starcat-io/jupiter-nano/jupiter-nano/stack-up.md

# Stack Up

- F.Cu   : route
- In1.Cu : GND
- In2.Cu : VDDCORE (1V2)
- In3.Cu : VDD_3V3 (3V3)
- In4.Cu : VDDIODDR (1V8)
- B.Cu   : route
