starcat-io/jupiter-nano/jupiter-nano/dimensions.txt

width 1.535 in  29.21  mm
height 2.48 in  69.992 mm
