starcat-io/jupiter-nano/jupiter-nano/3dmodels/ZX62-AB-5PA-gray.step

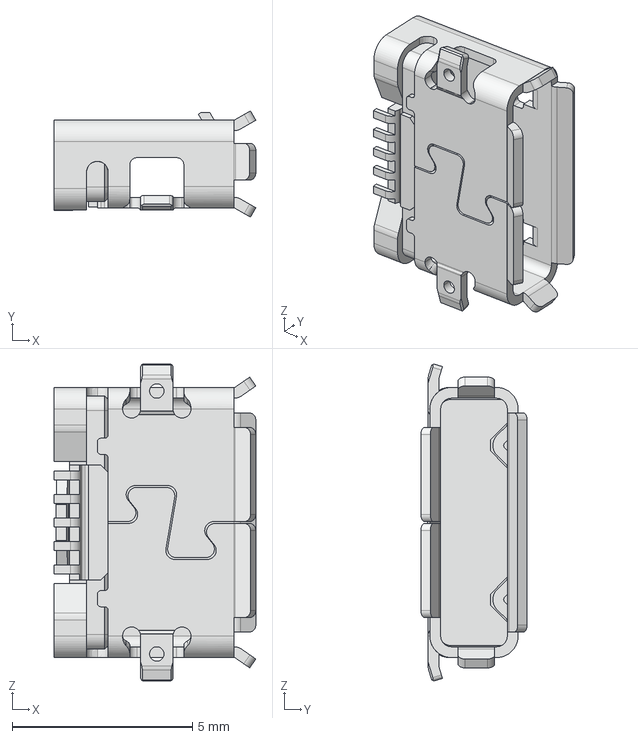
[picture p4: CAD file, 2021-07-31]
jupiter-nano/3dmodels/ZX62-AB-5PA-gray.step
5.60 x 2.95 x 8.80 mm
