starcat-io/jupiter-nano/jupiter-nano/3dmodels/PTS810_SJM_250_SMTR_LFS.step

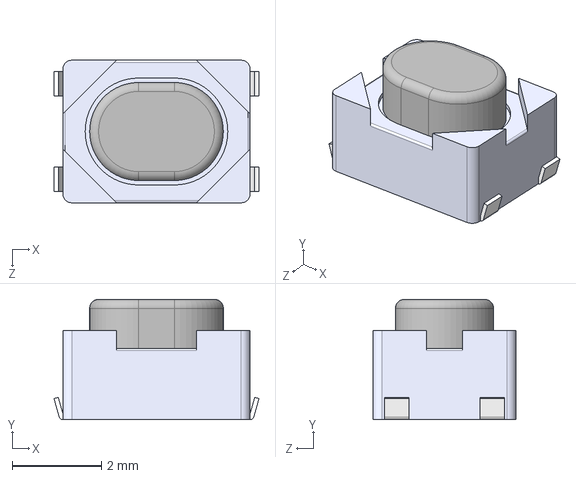
[picture p5: CAD file, 2021-07-31]
jupiter-nano/3dmodels/PTS810_SJM_250_SMTR_LFS.step
4.60 x 2.70 x 3.20 mm
