starcat-io/jupiter-nano/jupiter-nano/3dmodels/IND_TAIYO_NR3015_TAY.step

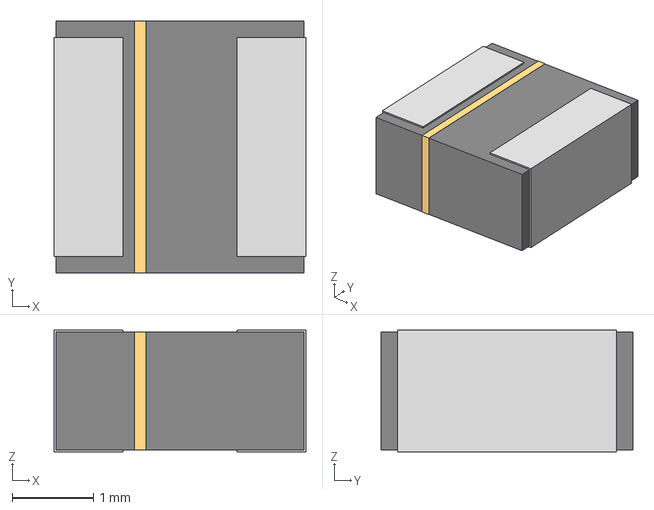
[picture p6: CAD file, 2020-11-12]
jupiter-nano/3dmodels/IND_TAIYO_NR3015_TAY.step
3.10 x 3.10 x 1.50 mm
