starcat-io/jupiter-nano/jupiter-nano/3dmodels/ZX62D-AB-5P8.step

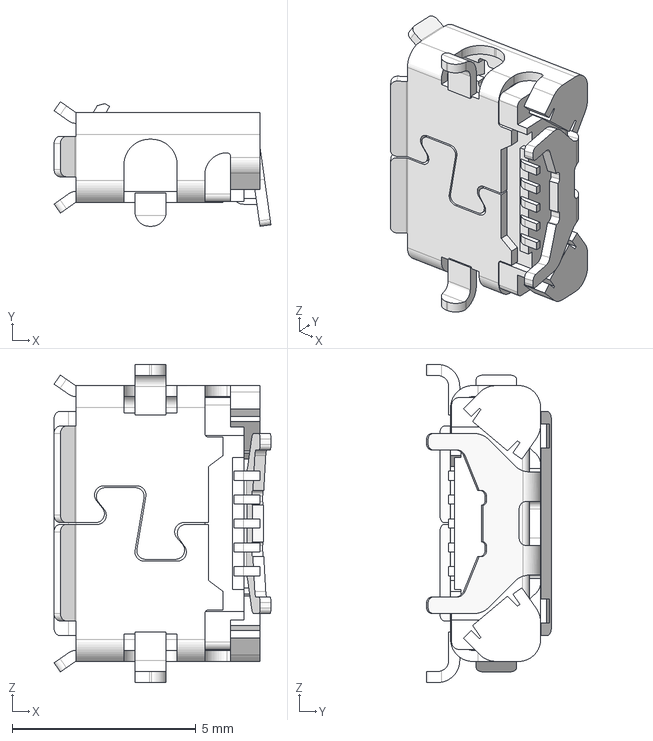
[picture p7: CAD file, 2020-11-12]
jupiter-nano/3dmodels/ZX62D-AB-5P8.step
5.90 x 3.39 x 8.65 mm
