starcat-io/jupiter-nano/jupiter-nano/3dmodels/QFN20_5x5MC_MCH.step

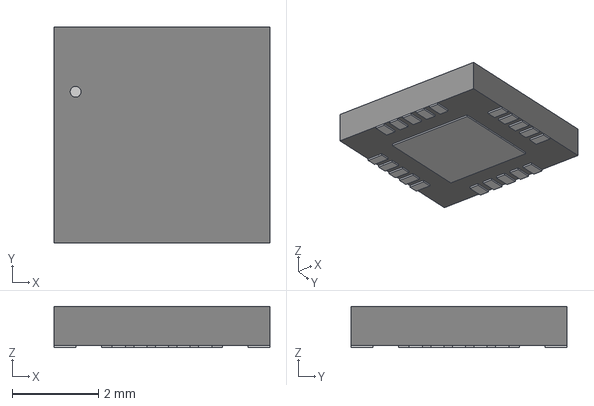
[picture p8: CAD file, 2020-11-12]
jupiter-nano/3dmodels/QFN20_5x5MC_MCH.step
5.00 x 5.00 x 0.952 mm
