starcat-io/jupiter-nano/jupiter-nano/3dmodels/UDFN8_2x3MC_MCH.step

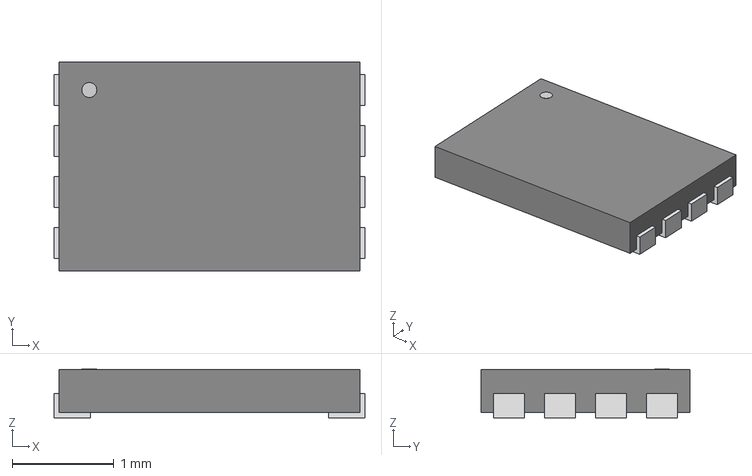
[picture p9: CAD file, 2020-11-12]
jupiter-nano/3dmodels/UDFN8_2x3MC_MCH.step
3.05 x 2.05 x 0.476 mm
