starcat-io/jupiter-nano/jupiter-nano/3dmodels/amphenol-sdcard-socket-1140084168.STEP

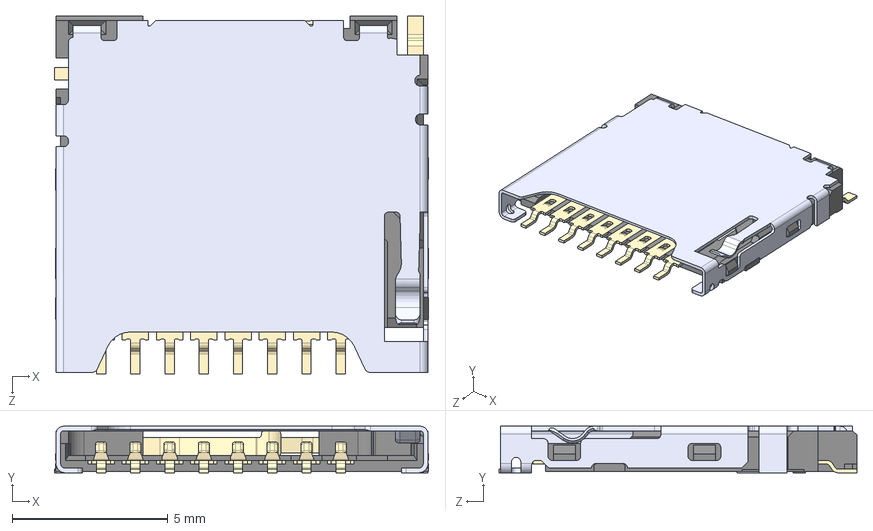
[picture p10: CAD file, 2020-11-12]
jupiter-nano/3dmodels/amphenol-sdcard-socket-1140084168.STEP
12.0 x 1.50 x 11.5 mm
