starcat-io/jupiter-nano/jupiter-nano/3dmodels/4WLCSP.step

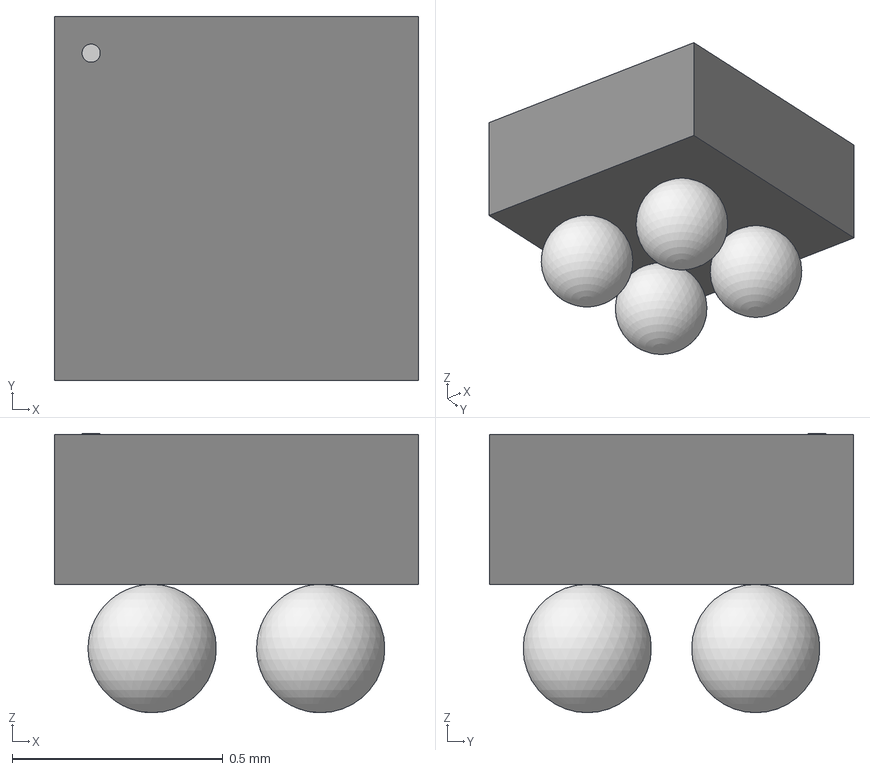
[picture p11: CAD file, 2020-11-12]
jupiter-nano/3dmodels/4WLCSP.step
0.864 x 0.864 x 0.663 mm
