starcat-io/jupiter-nano/jupiter-nano/3dmodels/TFBGA361_16X16_MCH.step

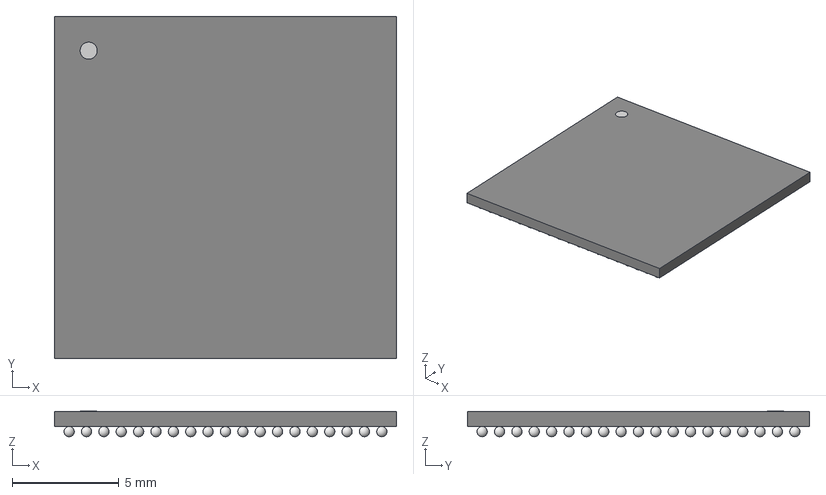
[picture p12: CAD file, 2020-11-12]
jupiter-nano/3dmodels/TFBGA361_16X16_MCH.step
16.0 x 16.0 x 1.20 mm
