starcat-io/jupiter-nano/jupiter-nano/3dmodels/SOT-23-5_M5_MCH.step

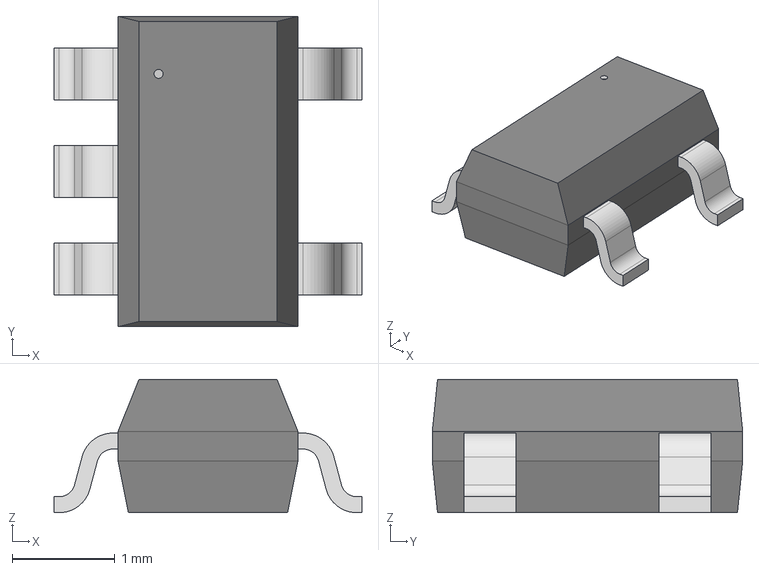
[picture p13: CAD file, 2020-11-12]
jupiter-nano/3dmodels/SOT-23-5_M5_MCH.step
3.00 x 3.02 x 1.30 mm
