starcat-io/jupiter-nano/jupiter-nano/3dmodels/TQFN55-40.STEP

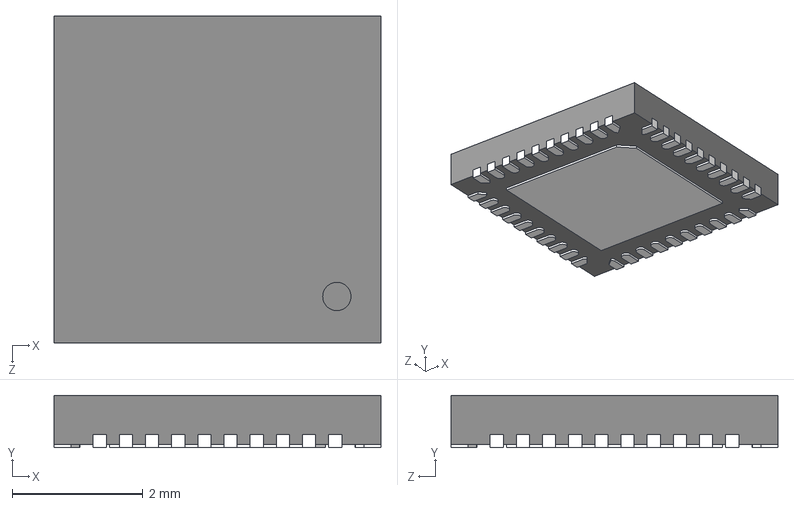
[picture p14: CAD file, 2020-11-12]
jupiter-nano/3dmodels/TQFN55-40.STEP
5.00 x 0.8 x 5.00 mm
