starcat-io/jupiter-nano/jupiter-nano/3dmodels/PTS810.step

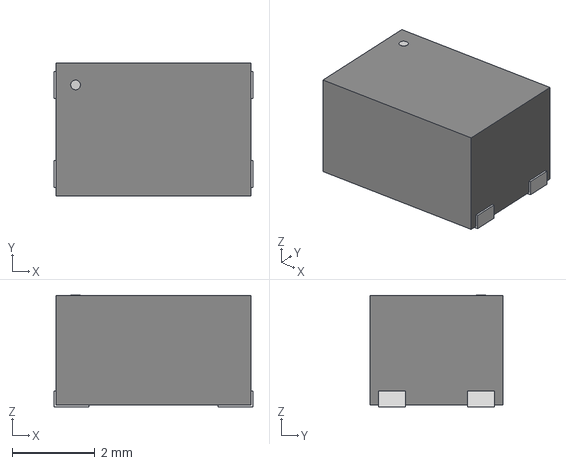
[picture p15: CAD file, 2020-11-12]
jupiter-nano/3dmodels/PTS810.step
4.80 x 3.20 x 2.69 mm
