starcat-io/jupiter-nano/jupiter-nano/3dmodels/NX3225SA.STEP

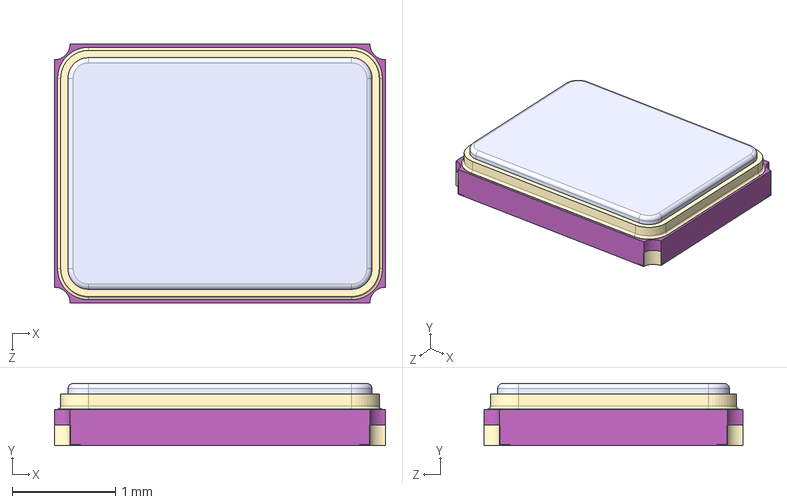
[picture p16: CAD file, 2020-11-12]
jupiter-nano/3dmodels/NX3225SA.STEP
3.20 x 0.6 x 2.50 mm
