starcat-io/jupiter-nano/(list of files, cad)

Other CAD files:
jupiter-nano/3dmodels/QFN20_5x5MC_MCH-M.step
jupiter-nano/3dmodels/ZX62-AB-5PA.stp
jupiter-nano/3dmodels/TFBGA361_16X16_MCH-L.step
jupiter-nano/3dmodels/TFBGA361_16X16_MCH-M.step
jupiter-nano/3dmodels/SOT-23-5_M5_MCH-M.step
jupiter-nano/3dmodels/UDFN8_2x3MC_MCH-L.step
jupiter-nano/3dmodels/UDFN8_2x3MC_MCH-M.step
jupiter-nano/3dmodels/QFN20_5x5MC_MCH-L.step
jupiter-nano/3dmodels/SOT-23-5_M5_MCH-L.step
jupiter-nano/3dmodels/M50-3600542.STEP
jupiter-nano/3dmodels/TQFN55-40.FCStd
