starcat-io/jupiter-nano/jupiter-nano/jupiter-nano-schematic.pdf

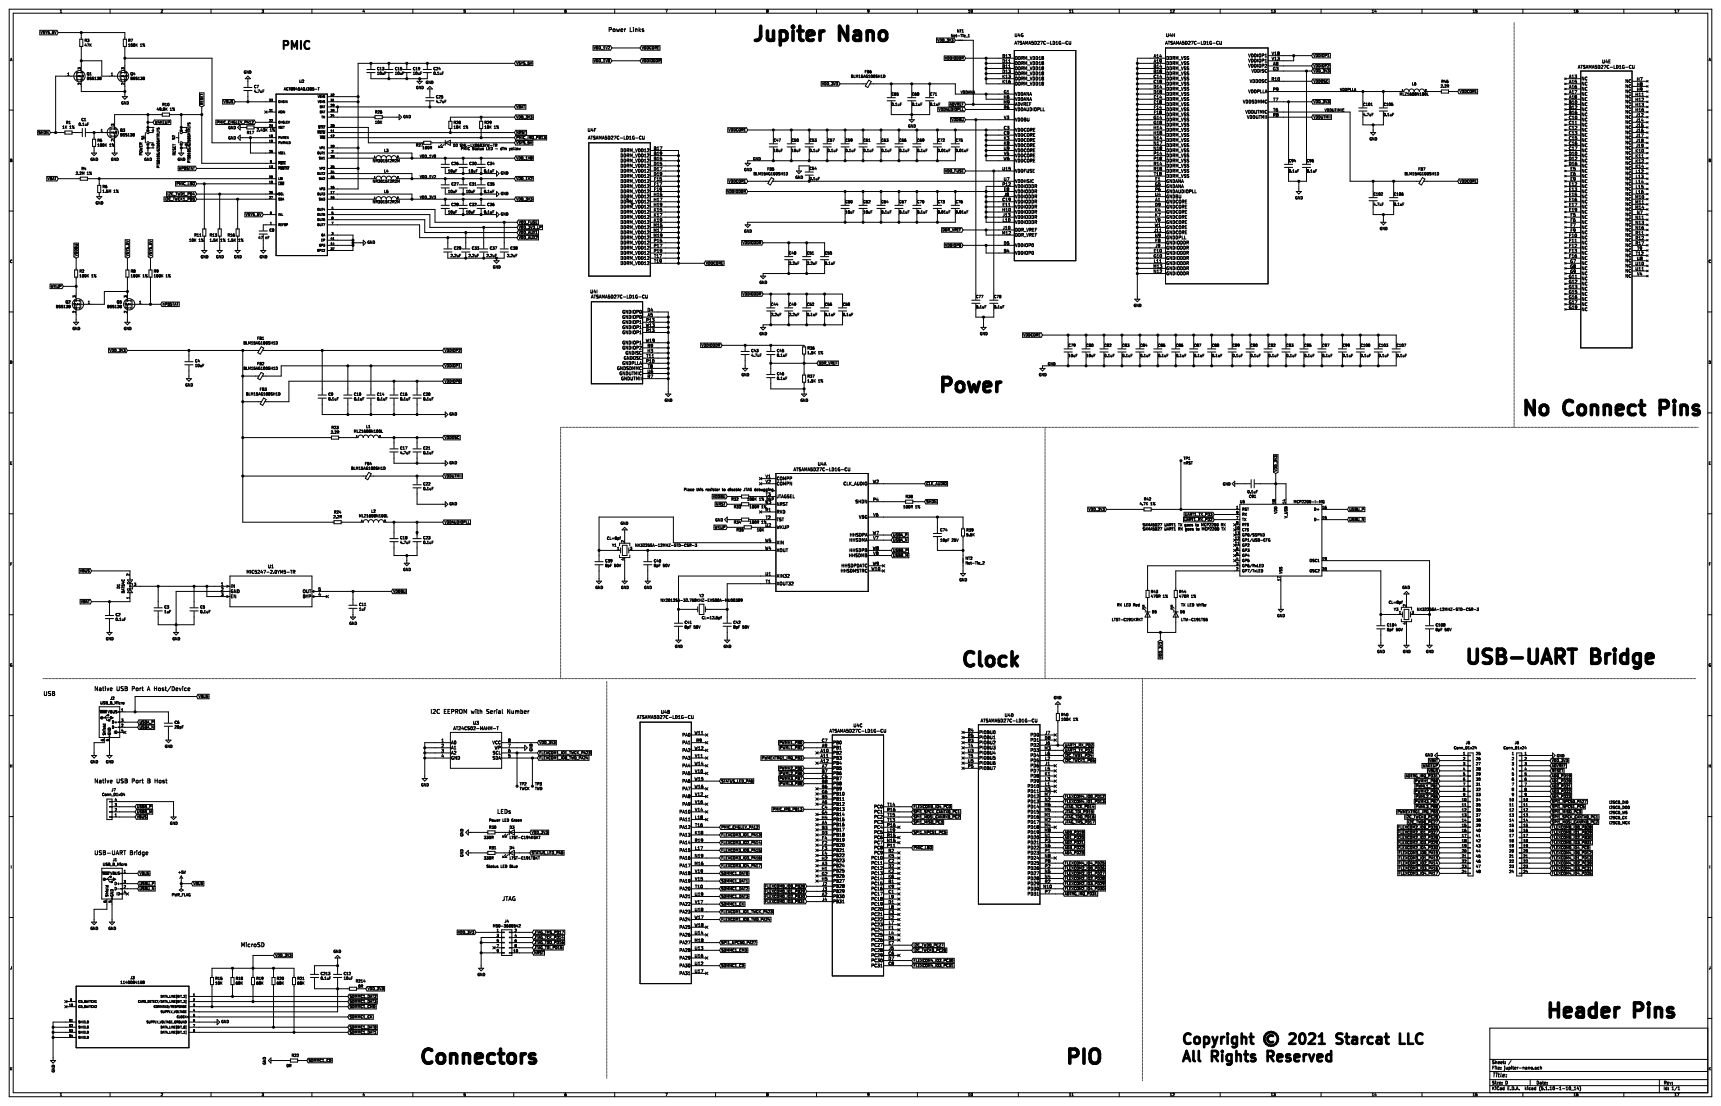
[picture p17: page 1]
