starcat-io/jupiter-nano/(commit log)

2020-08-26 initial addition of schematic, WIP
    [USB-UART-bridge.sch, connectors.sch, header-pins.sch, jupiter-nano.kicad_pcb, jupiter-nano.sch, pmic.sch, power.sch, sama5d27-clock.sch]
2020-08-26 PMIC WIP, PBIN and PWRHLD not done
    [pmic.sch]
2020-08-26 WIP, PMIC schematic done
    [pmic.sch]
2020-08-26 fixed error with INL
    [pmic.sch]
2020-08-27 work in progress on SAMA5D27 power
    [sama5d27-nc.sch, sama5d27-power1.sch, sama5d27-power2.sch]
2020-08-28 WIP – power3 done
    [USB-UART-bridge.sch, connectors.sch, header-pins.sch, jupiter-nano.sch, pmic.sch, sama5d27-clock.sch, sama5d27-nc.sch, sama5d27-pio.sch]
2020-08-31 added compoent numbers for power
    [sama5d27-power1.sch, sama5d27-power3.sch]
2020-08-31 values for power capacitors
    [sama5d27-power1.sch]
2020-09-01 WIP, power done
    [sama5d27-power1.sch, sama5d27-power2.sch]
2020-09-01 refcatoring SAMA5D27 pinout to improve schematic
2020-09-01 WIP some work on clocking
    [sama5d27-clock.sch, sama5d27-pio.sch]
2020-09-02 WIP clocking done
    [pmic.sch, sama5d27-clock.sch, sama5d27-power1.sch, sama5d27-power2.sch]
2020-09-02 WIP, PIO done
    [USB-UART-bridge.sch, sama5d27-clock.sch, sama5d27-pio.sch]
2020-09-02 WIP, connectors almost done
    - still to do:
    - JTAG signals on PIO pins
    - USB-UART bridge
    - extra PIO on the header pins
    [connectors.sch, header-pins.sch, sama5d27-clock.sch, sama5d27-power1.sch]
2020-09-02 added starcat lib with case ground
2020-09-02 WIP, USB-UART and JTAG done
    - minor clean up and SD Card form factor still left
    [USB-UART-bridge.sch, connectors.sch, sama5d27-pio.sch]
2020-09-02 reset logic R names, values; longer connnectors
    [header-pins.sch, jupiter-nano.sch, pmic.sch, sama5d27-clock.sch]
2020-09-02 add USBA VBUS sense; remove mounting holes
    [connectors.sch, sama5d27-pio.sch]
2020-09-02 ERC corrections
    [USB-UART-bridge.sch, connectors.sch, header-pins.sch, pmic.sch, sama5d27-clock.sch, sama5d27-pio.sch, sama5d27-power1.sch, sama5d27-power2.sch]
2020-09-03 numerous ERC fixes
    - still more to go
    [USB-UART-bridge.sch, connectors.sch, header-pins.sch, jupiter-nano.sch, pmic.sch, sama5d27-clock.sch, sama5d27-pio.sch, sama5d27-power1.sch]
2020-09-05 added at24csw080 I2C EEPROM UUID chip
    [connectors.sch, header-pins.sch, pmic.sch, sama5d27-clock.sch, sama5d27-pio.sch, sama5d27-power1.sch, sama5d27-power2.sch, sama5d27-power3.sch]
2020-09-05 reorganized connector sheet
    - and library location change
    [connectors.sch, jupiter-nano.sch, sama5d27-pio.sch]
2020-09-07 change to one-sheet schematic
    - rather than hierarchical
    [connectors.sch, header-pins.sch, jupiter-nano.sch, pmic.sch, power.sch, sama5d27-clock.sch, sama5d27-jtag.sch, sama5d27-nc.sch]
2020-09-08 completed pinout, ERC passed
    [jupiter-nano.sch]
2020-09-08 updated sd-card and usb connectors; some footprints
    - added connector libaries
    [jupiter-nano.sch]
2020-09-08 updated footprints
    [jupiter-nano.sch]
2020-09-09 preparation for pcbnew
    [jupiter-nano.sch]
2020-09-09 add pushbutton switch
2020-09-09 WIP on PCB- just started routing
    - not all components have footprints
    [jupiter-nano.kicad_pcb]
2020-09-10 WIP on routing board
    - placing components, not done yet
    [jupiter-nano.kicad_pcb, jupiter-nano.sch]
2020-09-10 WIP some movement of parts
    [jupiter-nano.kicad_pcb]
2020-09-10 WIP better part placement
    [jupiter-nano.kicad_pcb, jupiter-nano.sch]
2020-09-11 WIP – clock and PMIC components separated
    [jupiter-nano.kicad_pcb]
2020-09-14 WIP placement
    [jupiter-nano.kicad_pcb]
2020-09-15 WIP placements - PMIC in progress
    [jupiter-nano.kicad_pcb]
2020-09-15 connector positions locked, board corners radiused
    [jupiter-nano.kicad_pcb]
2020-09-16 all components placed; fixed I2C PMIC error
    - AT24CSW010 SPI Flash now on Flexcom1 TWD/TWCK
    - CAN RX/TX shared with SPI1
    [jupiter-nano.kicad_pcb, jupiter-nano.sch]
2020-09-16 updated SAMA5D27 lib to have better nc pin order
    [jupiter-nano.kicad_pcb, jupiter-nano.sch]
2020-09-16 better placements
    [jupiter-nano.kicad_pcb]
2020-09-17 added MacroFab design rules
    [jupiter-nano.kicad_pcb]
2020-09-17 deleted extra J1
    [jupiter-nano.kicad_pcb, jupiter-nano.sch]
2020-09-17 tied USB case ground to system ground
    [jupiter-nano.sch]
2020-09-18 re-routed usb traces with 3 track width spacing
    [jupiter-nano.kicad_pcb, jupiter-nano.sch]
2020-09-18 re-routed USB-UART traces with 3 track spacing
    [jupiter-nano.kicad_pcb]
2020-09-19 SDMMC traces routed and length-tuned
    [jupiter-nano.kicad_pcb]
2020-09-22 WIP routing, JTAG mostly done
    - 379 items still unconnected
    [jupiter-nano.kicad_pcb]
2020-09-22 WIP — JTAG all routed
    - 379 unconnected items
    [jupiter-nano.kicad_pcb]
2020-09-22 WIP - some PMIC traces routed
    - 345 unconnected elements
    [jupiter-nano.kicad_pcb]
2020-09-22 WIP routing — part of J3 connected
    - about 254 unconnected elements
    [jupiter-nano.kicad_pcb]
2020-09-23 WIP - J3 connected
    - about 248 unconnected elements
    [jupiter-nano.kicad_pcb]
2020-09-23 WIP - VDDCORE and VDDIOCORE
    - VDDCORE caps all placed
    - most of VDDIOCORE caps placed
    - schematic updated to match
    [jupiter-nano.kicad_pcb, jupiter-nano.sch]
2020-09-24 WIP - lots more traces routed
    - about 150 unconnected elements
    - connector J4 still needs routing
    [jupiter-nano.kicad_pcb]
2020-09-24 WIP - routing PMIC traces
    - about 159 unconnected elements
    [jupiter-nano.kicad_pcb]
2020-09-25 update netlist
    [jupiter-nano.kicad_pcb]
2020-09-29 WIP J4 1-11 routed; fixed MCP GND cap
    - about 136 unconnected items
    [jupiter-nano.kicad_pcb, jupiter-nano.sch]
2020-09-29 WIP - more traces routed
    - about 95 unconnected elements
    - about half of J4 left to do
    [jupiter-nano.kicad_pcb]
2020-09-29 WIP - more J4 routing
    - 10 more J4 pins to route
    - about 87 unconnected elements
    [jupiter-nano.kicad_pcb]
2020-09-30 WIP - J4 all routed
    - about 75 unconnected elements
    [jupiter-nano.kicad_pcb]
2020-09-30 placed ferrite beads
    - about 69 unconnected elements
    [jupiter-nano.kicad_pcb, jupiter-nano.sch]
2020-09-30 WIP - more routing
    - about 60 unconnected elements remaining
    [jupiter-nano.kicad_pcb]
2020-10-01 fixed zone fills to remove islands
    - and fill more area
    - about 48 unconnected elements
    [jupiter-nano.kicad_pcb]
2020-10-01 WIP - still more routing
    - about 35 unconnected elements
    [jupiter-nano.kicad_pcb]
2020-10-02 zone work to connect VDDCORE regions
    [jupiter-nano.kicad_pcb, jupiter-nano.sch]
2020-10-02 WIP - more connections and zone work
    - about 24 unconnected elements
    [jupiter-nano.kicad_pcb]
2020-10-02 WIP - more trace routing
    - about 8 unconnected elements
    [jupiter-nano.kicad_pcb]
2020-10-02 100% routed, just case grounds missing
    - all zones look good too.
    - some DRC errors need to be checked
    [jupiter-nano.kicad_pcb]
2020-10-02 fixed unconnected traces, checked DRC errors
    - only errors are in USB connectors
    [jupiter-nano.kicad_pcb]
2020-10-02 added edge of board clearance to do
2020-10-02 fixed edge of board clearance (10 mil)
    [jupiter-nano.kicad_pcb]
2020-10-02 moved sdmmc connector back from edge
    - for 10 mil clearance to pads
    [jupiter-nano.kicad_pcb]
2020-10-02 length tuned SDMMC traces (retuned)
    [jupiter-nano.kicad_pcb]
2020-10-02 retuned USB traces
    [jupiter-nano.kicad_pcb]
2020-10-02 refilled zones
    [jupiter-nano.kicad_pcb]
2020-10-02 cleaned up schematic
    - adjusted some decoupling capacitor values
    [jupiter-nano.kicad_pcb, jupiter-nano.sch]
2020-10-15 updated SD Card socket origin
    [jupiter-nano.kicad_pcb]
2020-10-18 added 3d models- board renders completely
    [IND_TAIYO_NR3015_TAY.step, M50-3600542.STEP, NX3225SA.STEP, PTS810.step, QFN20_5x5MC_MCH-L.step, QFN20_5x5MC_MCH-M.step, QFN20_5x5MC_MCH.step, TFBGA361_16X16_MCH-L.step]
2020-10-18 added model for U4 MIC5247-2.0YM5-TR
    [SOT-23-5_M5_MCH-L.step, SOT-23-5_M5_MCH-M.step, SOT-23-5_M5_MCH.step, jupiter-nano.kicad_pcb]
2020-10-20 added pin numbers to silkscreen
    - also added 3d model for AT24CSW010
    [4WLCSP.step, jupiter-nano.kicad_pcb]
2020-10-20 updated the 3.3v-advref nettie location
    [jupiter-nano.kicad_pcb]
2020-10-21 pcb fixup after viewing gerbers
    - no major errors, just cosmetic
    [jupiter-nano.kicad_pcb]
2020-10-27 fixing MacroFab-caught errors: LEDs
    [jupiter-nano.kicad_pcb, jupiter-nano.sch]
2020-10-28 changed to UDFN EEPROM; updated Y1 footprint
    [UDFN8_2x3MC_MCH-L.step, UDFN8_2x3MC_MCH-M.step, UDFN8_2x3MC_MCH.step, jupiter-nano.sch]
2020-10-28 fix footprint problems - LEDs and crystals
    [jupiter-nano.kicad_pcb]
2020-10-28 fixed DRC errors and unnconnected traces
    [jupiter-nano.kicad_pcb]
2020-10-30 changed USB connectors to SMD
    - to prevent hole problems
    - and interference with SD Card connector
    [ZX62-AB-5PA.stp, jupiter-nano.kicad_pcb, jupiter-nano.sch]
2020-10-30 updated 3d models and reference locations
    [jupiter-nano.kicad_pcb]
2020-10-30 cosmetic reference location changes
    [jupiter-nano.kicad_pcb, jupiter-nano.sch]
2021-02-01 added JTAG pin 1, console, and usb indicators
    - moved license text
    - moved Starcat copyright text
    [jupiter-nano.kicad_pcb]
2021-02-01 fixed MCP2200 power
    [jupiter-nano.sch]
2021-02-01 various schematic fixes - GNDUTMII and others
    - removed VBUS_SENSE
    - R28 is now 10K
    - R1 is now 1K
    - GNDUTMII goes directly to ground
    [jupiter-nano.sch]
2021-02-02 removed erroneous R25 on VBAT, other small changes
    - minor cosmetic changes
    [jupiter-nano.sch]
2021-02-02 legend changes
    [jupiter-nano.kicad_pcb, jupiter-nano.sch]
2021-02-02 routed all unconnected traces; added test points
    - test points are for UUID EEPROM
    - power redesign still not done
    [jupiter-nano.kicad_pcb, jupiter-nano.sch]
2021-02-03 fixed power routing - vbus and vbat
    - minor DRC fixes, lots more to do
    [jupiter-nano.kicad_pcb, jupiter-nano.sch]
2021-02-03 vsys_5v trace widened to 12mil
    [jupiter-nano.kicad_pcb]
2021-02-04 fixing DRC errors, more still to do
    [jupiter-nano.kicad_pcb]
2021-02-04 fixed all DRC errors, no unconnected traces
    [jupiter-nano.kicad_pcb]
2021-02-04 fixed 3 unconnected traces that were missed
    - really no more unconnected traces this time!
    [jupiter-nano.kicad_pcb]
2021-02-04 added additional via to VBUS trace
    - at board edge, for additional current flow
    [jupiter-nano.kicad_pcb]
2021-02-04 minor legend changes - j5 j6 nearer connectors
    [jupiter-nano.kicad_pcb]
2021-02-04 VDDUTMII and GNDUTMII trace widening; legend
    - added JTAG legend
    - added GND, 3V3, RESET, VBUS, and VBAT legends
    [jupiter-nano.kicad_pcb]
2021-02-04 VDDUTMII and GND trace widening
    [jupiter-nano.kicad_pcb]
2021-02-09 legend updates; minor routing updates
    - added flexcom legend at edge of board
    - minor trace widening
    [jupiter-nano.kicad_pcb, jupiter-nano.sch]
2021-02-15 fixed board edge clearance problems
    - everything is more than 19mils now
    [jupiter-nano.kicad_pcb, jupiter-nano.sch]
2021-03-03 layer visibility
    [jupiter-nano.kicad_pcb]
2021-04-13 SDMMC tracks routed, but not length-tuned
    [jupiter-nano.kicad_pcb]
2021-04-13 SDMMC routed, partially tuned
    [jupiter-nano.kicad_pcb]
2021-04-13 SDMMC traces length tuned
    - no pullup resistors connected
    [jupiter-nano.kicad_pcb]
2021-04-13 SDMMC pullup resistors connected; DRC passed
    [jupiter-nano.kicad_pcb]
2021-04-13 added RESET and WAKEUP button labels
    [jupiter-nano.kicad_pcb]
2021-04-13 changed console VBUS trace to 16 mil
    [jupiter-nano.kicad_pcb]
2021-04-13 bump version identifier to 1.0.0
    [jupiter-nano.kicad_pcb]
2021-04-13 moved traces to prepare for USB-B header
    - buttons moved closer to USBA connector
    - rerouted some traces to other layers to get off Front
    [jupiter-nano.kicad_pcb]
2021-04-14 added USB-B 4-pin header
    - rerouted and length-tuned USB-A traces
    - length-tuned USB-B traces
    - lots of rerouting other traces
    - DRC passes
    - legend for USB-B connector
    [jupiter-nano.kicad_pcb, jupiter-nano.sch]
2021-04-14 moved CONSOLE label to be more readable
    [jupiter-nano.kicad_pcb]
2021-04-14 removed small kink in USBA_N trace
    - tuned both USBA trace lengths
    [jupiter-nano.kicad_pcb]
2021-04-14 U3 label size and position change
    [jupiter-nano.kicad_pcb]
2021-04-14 adjusted USB-B position
    [jupiter-nano.kicad_pcb]
2021-04-14 switched USB-B connector pins
    - for routing convenience
    [jupiter-nano.sch]
2021-04-15 changed MCP2200 power to 12 mil traces (from 5)
    [jupiter-nano.kicad_pcb]
2021-04-16 adjusted MCP2200 power traces
    [jupiter-nano.kicad_pcb]
2021-04-16 moved SDMMC power filtering caps closer
    - closer to connector
    [jupiter-nano.kicad_pcb]
2021-04-17 moved SDMMC filtering caps even closer
    - even closer to connector
    [jupiter-nano.kicad_pcb]
2021-04-20 hide console usb part name
    [jupiter-nano.kicad_pcb]
2021-04-20 moved reset switch to free up space for USB-B
    - moved wakeup switch to match
    [jupiter-nano.kicad_pcb]
2021-04-21 added SDMMC decoupling capacitors
    [jupiter-nano.kicad_pcb, jupiter-nano.sch]
2021-04-21 enlarged SDMMC decoupling cap traces
    [jupiter-nano.kicad_pcb]
2021-04-21 bump version number to 1.1
    [jupiter-nano.kicad_pcb]
2021-04-22 SAMA5D27 orientation marker; bump point version
    - to v1.0.1
    [jupiter-nano.kicad_pcb]
2021-04-22 removed I/O pin header 3D models
    - also removed I2C eeprom part number so it won't show up in 3D renders
    [jupiter-nano.kicad_pcb]
2021-04-27 zone fill tuning
    [jupiter-nano.kicad_pcb]
2021-04-29 minor adjustments to SDMMC termination resistors
    - also bump version label to v1.0.2
    [jupiter-nano.kicad_pcb]
2021-05-07 routing optimization related to MCP2200 pads
    - avoiding thermal pads
    [jupiter-nano.kicad_pcb]
2021-05-07 more trace optimization, fixing sharp bends
    [jupiter-nano.kicad_pcb]
2021-05-10 update orientation marks for all IC
    - SAMA5D27 - put orientation circle into library
    - MCP2200 - made orientation circle larger
    - ACT8945A - removed asterisk, added large orientation circle, removed
    extraneous corner markings
    All for clarity on PCB to reduce the chance of orientation errors
    [jupiter-nano.kicad_pcb]
2021-05-12 updated ACT8945A-305T 3d model - white dot
    - white dot for orientation marker
    [TQFN55-40.FCStd]
2021-05-12 removed vias from MCP2200 library and footprint
    - thermal vias in pad act as solder acqueducts
2021-05-12 removed unused 3d model
    - now using WRL file for colors
    [TQFN55-40-1.STEP]
2021-05-12 moving vias out of BGA pads
    - to prevent solder aqueducts
    [jupiter-nano.kicad_pcb]
2021-05-12 changed MCP2200 footprint to thermal holes version
    [jupiter-nano.kicad_pcb]
2021-05-17 move vias to avoid via-in-pad for SAMA5 BGA
    [jupiter-nano.kicad_pcb]
2021-05-18 removed more via-in-pad; bumped minor version
    [jupiter-nano.kicad_pcb]
2021-05-25 removed stray unconnected trace
    [jupiter-nano.kicad_pcb]
2021-05-25 added CK pushbutton switch libraries and model
    - more accurate
    [PTS810_SJM_250_SMTR_LFS.step]
2021-05-25 changed view
    [jupiter-nano.kicad_pcb]
2021-07-21 added ZX62-AB-5PA-gray.step
    - changing color from blue to gray
    [ZX62-AB-5PA-gray.step]
2021-07-21 updated micro usb connectors to be gray
    - instead of blue
    [jupiter-nano.kicad_pcb]
2021-07-31 various cleanups
    - removed unused files
    - added stack-up.md
    - updated README.md
    [USB-UART-bridge.sch, sama5d27-power1.sch, sama5d27.sch]
