starcat-io/jupiter-nano/(notices)

Notices in the files:
jupiter-nano/jupiter-nano.kicad_pcb:
License v2.0 (CERN-OHL-S)
Copyright © 2021 Starcat LLC
parts and their libraries:
Copyright 2016 Accelerated Designs. All rights reserved.
